PigsCanFlyLabs/satellite-hardware/v0.1/PCB_Project/Schematics.pdf

# Swarm M138 Modem ¹

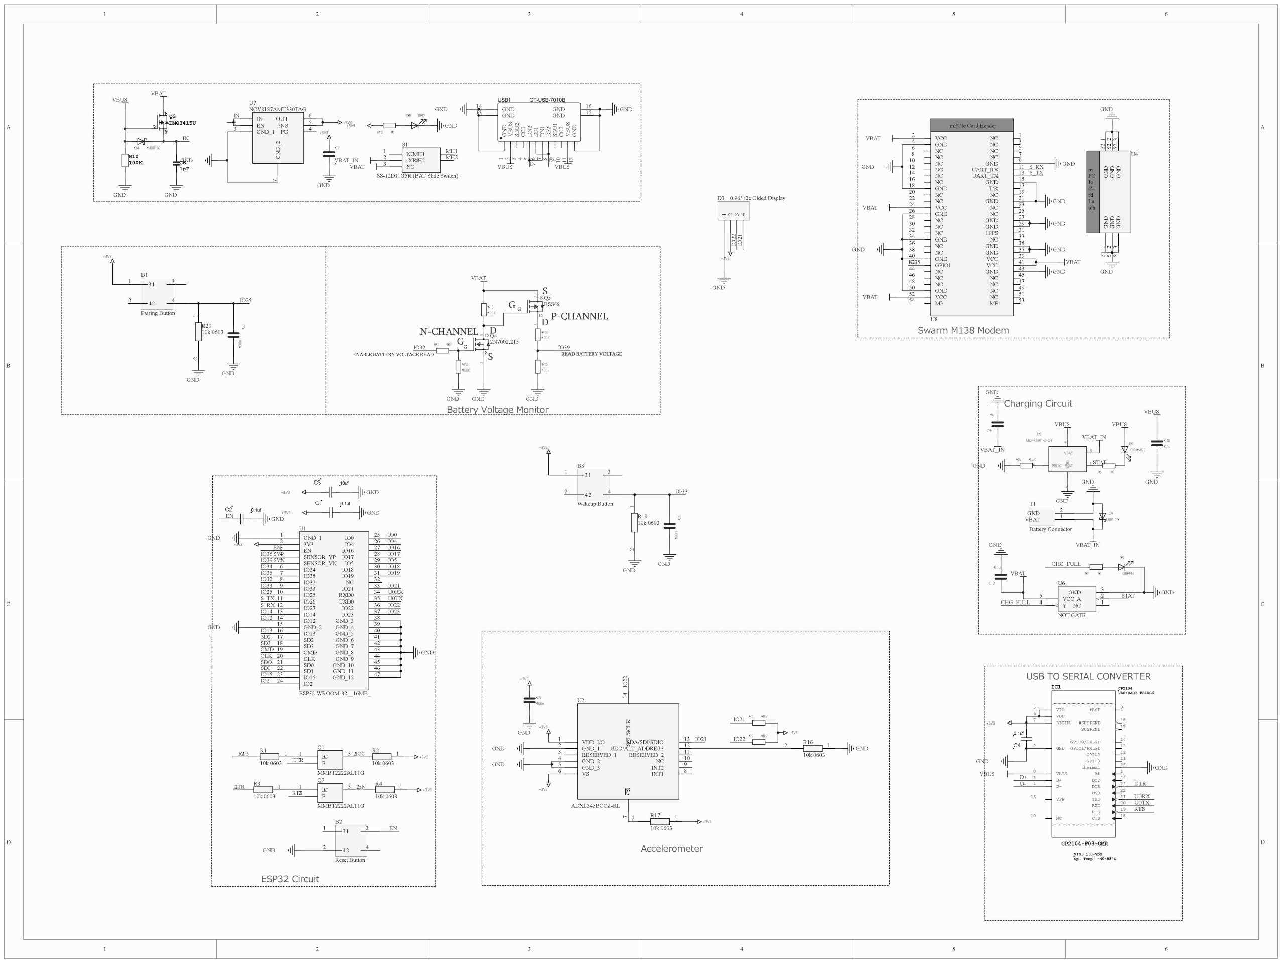
[picture p1: page 1]

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
GND_1 1
3V3 2
EN 3
SENSOR_VP 4
SENSOR_VN 5
IO34 6
IO35 7
IO32 8
IO33 9
IO25 10
IO26 11
IO27 12
IO14 13
IO12 14
GND_2 15
IO13 16
SD2 17
SD3 18
CMD 19
CLK 20
SD0 21
SD1 22
IO15 23
IO2 24
IO0 | 25
IO4 | 26
IO16 | 27
IO17 | 28
IO5 | 29
IO18 | 30
IO19 | 31
NC | 32
IO21 | 33
RXD0 | 34
TXD0 | 35
IO22 | 36
IO23 | 37
GND_3 | 38
GND_4 | 39
GND_5 | 40
GND_6 | 41
GND_7 | 42
GND_8 | 43
GND_9 | 44
GND_10 | 45
GND_11 | 46
GND_12 | 47

U1

ESP32-WROOM-32__16MB_

+3V3

GND
EN
SVP
IO39 SVN
IO34
IO35

IO12

IO13

IO14

IO15

IO16
IO17

IO18
IO19

IO21

IO22
IO23

IO25

IO32
IO33

GND
SD2
SD3
CMD
CLK

SDI

SDO

U0TX

U0RX

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
MMBT2222ALT1G

B

1
E

2

C

3

Q2

MMBT2222ALT1G

2 1

R1

10k 0603

2 1

R3

10k 0603

2 1

R2
10k 0603 DTR

RTS

+3V3

IO36

C2 | 0.1uf
C1 | 0.1uf
+3V3 | GND EN | GND

2 1

R4

10k 0603

+3V3

RTS

DTR | EN IO0
C3 | 10uf
+3V3 | GND

+3V3

U0RX
U0TX
RTS

DTR

RI | 1

GND 2

D+ 3
D- 4

VIO 5
VDD 6
REGIN 7

VBUS 8

#RST | 9

NC 10

GPIO3 | 11
GPIO2 | 12
DCD | 24
DTR | 23
DSR | 22
TXD | 21
RXD | 20
RTS | 19
CTS | 18
SUSPEND | 17

VPP 16

#SUSPEND | 15

GPIO0/TXLED | 14
GPIO1/RXLED | 13

CP2104
USB/UART BRIDGE

VIO: 1.8-VDD
Op. Temp: -40~85°C
thermal | 25

IC1

CP2104-F03-GMR

0.1uf
C4

GND
GND
D+
D-

+3V3

100n

C5

# ESP32 Circuit

# Accelerometer

GND

0.1u

C10

ORANGE

D2

R6 1K VDD

4

PROG 5

VBAT | 3
STAT | 1 VSS 2

MCP73831-2-OT

U3

R5 1.5K

MBR120

D1
VBAT | 1
GND | 2

T1

Battery Connector

VBAT_IN

GND

VBUS

VBUS

GND

VBUS

GND

GND

# Charging Circuit

2

3

4

D3 0.96" i2c Olded Display

GND

+3V3 IO²² IO²¹

C6
1µF

D

S

G

Q3
DMG3415U

R10
100K

VBUS

VBAT

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
Pairing Button

# USB TO SERIAL CONVERTER

NC | 1
A | 2
GND | 3

Y

4

VCC 5

U6

NOT GATE

STAT | GND
CHG_FULL
VBAT | GREEN

D5

R7 1K

CHG_FULL ¹⁰⁰n C⁸

GND

IN

IN 1
EN 2
GND_1 3 | GND_2

### 7 OUT 6

SNS | 5
PG | 4

U7
NCV8187AMT330TAG
GND | GND

GND

IN
+3V3

NC 1
COM 2
NO 3
MH1 | MH1
MH2 | MH2

S1

SS-12D11G5R (BAT Slide Switch)

VBAT_IN
VBAT

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
Reset Button

GND

EN

+3V3

1u

C7

GND

VBUS

D4 | MBR120 | GND S¹_1 GND S²_1 GND S¹_2 GND S¹_3 GND S²_2 GND S²_3

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
mPCIe Card Header

MP 54 | MP | 53
NC | 1
NC | 3
NC | 5

VCC 2
GND 4
NC 6
NC 8
NC 10
NC 12
NC 14
NC 16
NC | 7
GND | 9
UART_RX | 11
UART_TX | 13
T/R | 17
NC | 19
GND | 21
NC | 23
NC | 25
GND | 27
GND | 29
1PPS | 31
NC | 33
GND | 35
GND | 37
VCC | 39
VCC | 41
GND | 43
NC | 45
NC | 47
NC | 49
NC | 51

GND 18
NC 20
NC 22
VCC 24
GND 26
NC 28
NC 30
NC 32
GND 34
NC 36
NC 38
GND 40
GND | 15

GPIO1 42
NC 44
NC 46
NC 48
GND 50
VCC 52

U8

GND

VBAT

VBAT

GND

VBAT

GND

VBAT

GND

GND

GND

GND

GND

GND

S_RX
S_TX

S_TX
S_RX

GND

0.1u

C12

VBAT_IN

STAT

GND

1u

C9

VBAT_IN GND

# 1 VBUS 2 SBU2

# 3 CC1

# 4 DN2

# 5 DP1

# 6 DN1

# 7 DP2

# 8 SBU1

### 9 CC2 10 VBUS 11 GND 12

GND 13 | GND 14
GND | 15 GND | 16
USB1 | GT-USB-7010B
GND | GND
VBUS | VBUS

D+ D-

100K

R14

R11 4K7

100K

R13

100K

R12
100k

R15

IO32 | IO39
S

G

D

S
G
D

# N-CHANNEL

# P-CHANNEL

ENABLE BATTERY VOLTAGE READ | READ BATTERY VOLTAGE ³

1 2

G
S

D Q4

2N7002,215 2

1 3

G

S

D

Q5
BSS48
GND | GND | GND

VBAT

# Battery Voltage Monitor

VDD_I/O 1
GND_1 2
RESERVED_1 3
GND_2 4
GND_3 5
VS 6 | CS

7

INT1 | 8
INT2 | 9
NC | 10 RESERVED_2 | 11 SDO/ALT_ADDRESS | 12 SDA/SDI/SDIO | 13 SCL/SCLK ¹⁴
U2

ADXL345BCCZ-RL

R8 | 4k7
R9 | 4k7

+3V3
IO21

IO21 IO²²

IO22
2 1

R16

10k 0603

GND

+3V3

+3V3

GND

GND

2 1

R17

10k 0603

+3V3

D6 | RED
R18 | 1K
+3V3 | GND 1 2

R20
10k 0603

GND

IO25

+3V3

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
Wakeup Button | 100n C¹¹
GND ¹ ²
R19
10k 0603

GND

IO33

+3V3

IO35
