PigsCanFlyLabs/satellite-hardware/v0.1/PCB_Project/bom support.txt

MM60-52B1-B1-R850
MM60-EZH039-B5-R850
CP2104-F03-GMR
