PigsCanFlyLabs/satellite-hardware/v0.3/tinyshuffle-sw/TinyShuffle TOP v.0.SLDASM

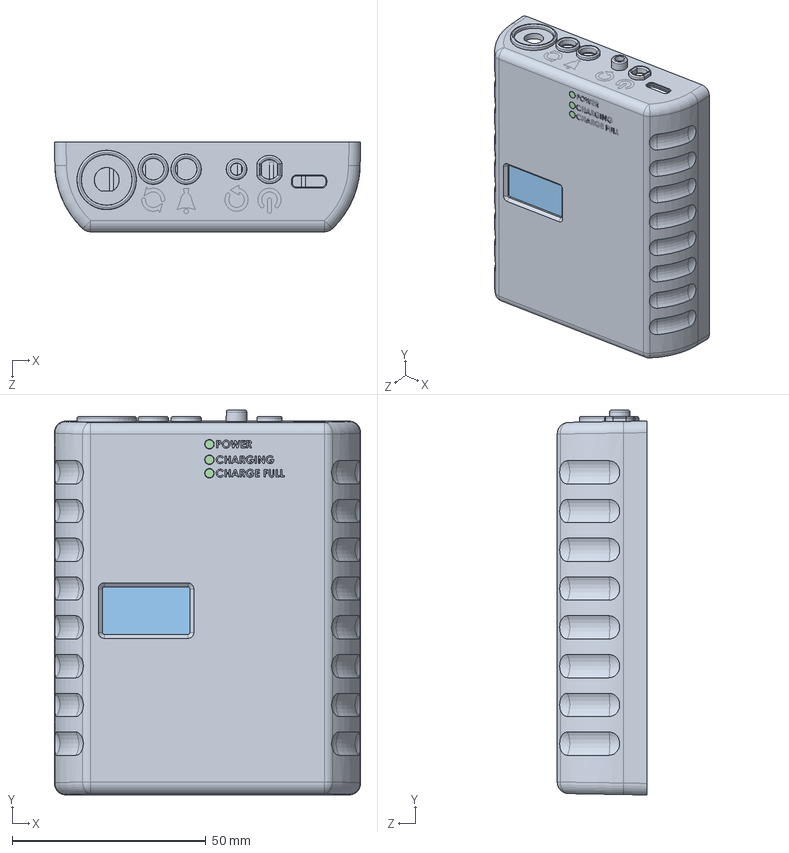
[picture p2: CAD file, 2022-03-25, an earlier design]
v0.3/tinyshuffle-sw/TinyShuffle TOP v.0.SLDASM
79.0 x 99.3 x 23.1 mm
TinyShuffle TOP v.0
94459A110_Heat-Set Inserts for Plastic m2X2.5 x 11
TinyShuffle Display filter v.0
BIVAR PLPC2-8MM x 3
