PigsCanFlyLabs/satellite-hardware/v0.3/COMPONENTS/Swarm-1_4-wave-antenna-model.STEP

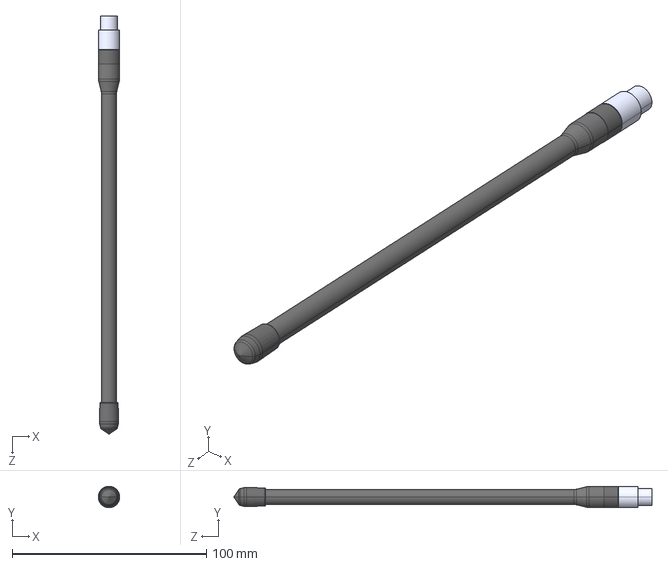
[picture p3: CAD file, 2022-03-25, an earlier design]
v0.3/COMPONENTS/Swarm-1_4-wave-antenna-model.STEP
11.0 x 11.0 x 215.1 mm
