PigsCanFlyLabs/satellite-hardware/v0.3/PCBA/SWARM M138.SLDPRT

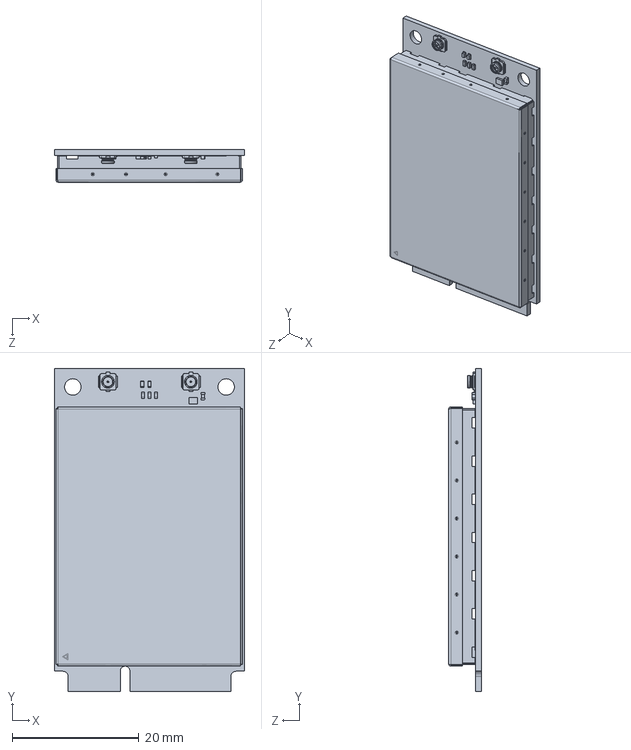
[picture p4: CAD file, 2022-03-21, an earlier design]
v0.3/PCBA/SWARM M138.SLDPRT
30.0 x 51.0 x 5.13 mm
