PigsCanFlyLabs/satellite-hardware/v0.3/SW/COMPONENTS/BODIES/QFN_F03-GMR_SIL.step

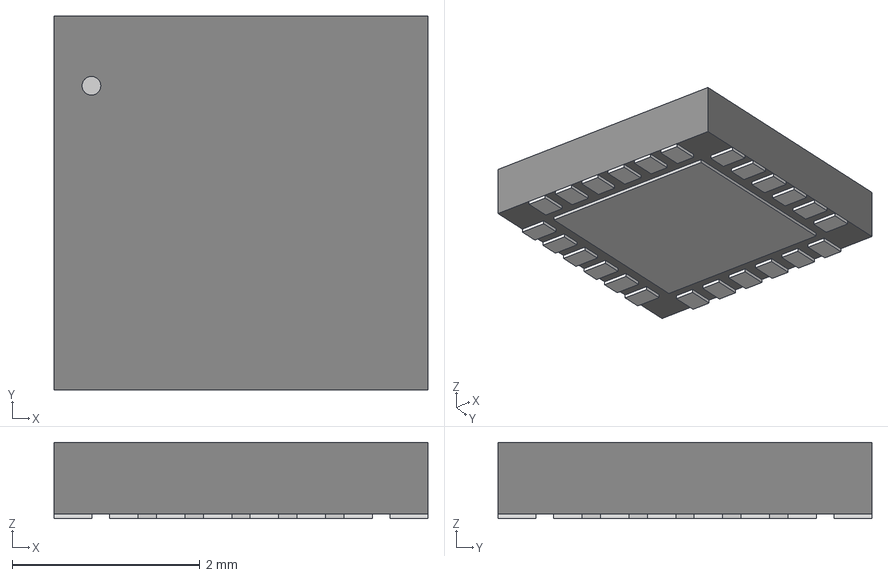
[picture p5: CAD file, 2022-03-21, an earlier design]
v0.3/SW/COMPONENTS/BODIES/QFN_F03-GMR_SIL.step
3.99 x 3.99 x 0.815 mm
