PigsCanFlyLabs/satellite-hardware/v0.3/SW/TinyShuffle SMA SEAL v.0.SLDPRT

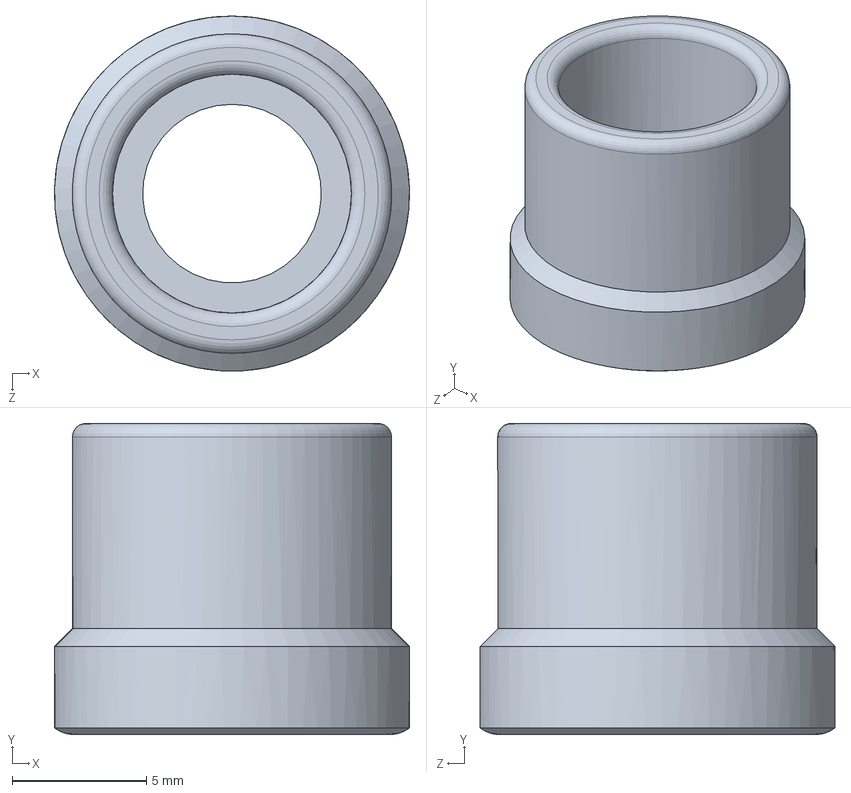
[picture p6: CAD file, 2022-03-21, an earlier design]
v0.3/SW/TinyShuffle SMA SEAL v.0.SLDPRT
13.2 x 11.6 x 13.2 mm
