PigsCanFlyLabs/satellite-hardware/v0.4/tinyshuffle-sw/TinyShuffle SHIM v.0.SLDPRT

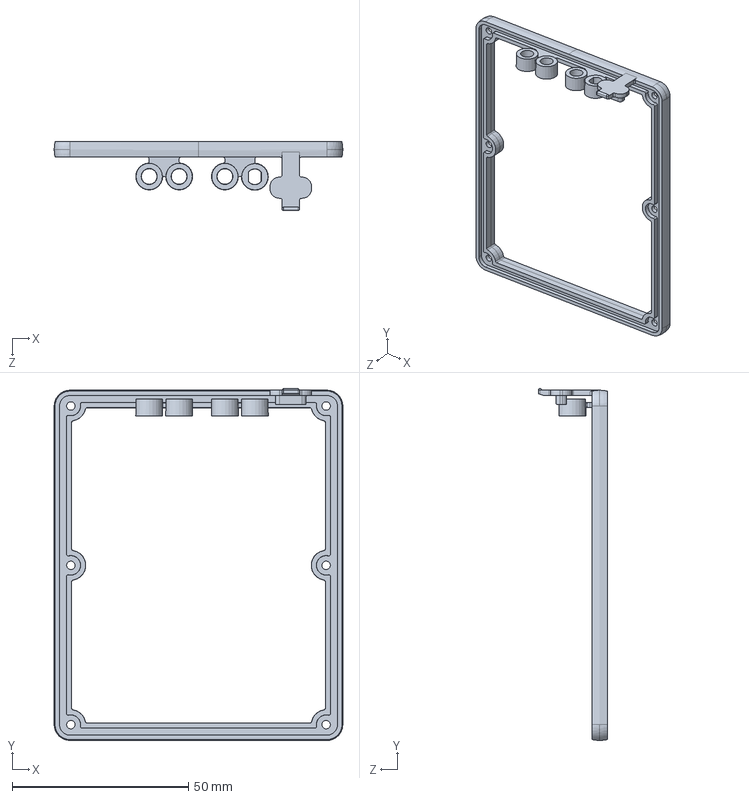
[picture p7: CAD file, 2022-03-25, an earlier design]
v0.4/tinyshuffle-sw/TinyShuffle SHIM v.0.SLDPRT
82.0 x 100.0 x 19.7 mm
