PigsCanFlyLabs/satellite-hardware/v0.3/COMPONENTS/800AC1BLKCAP.SLDPRT

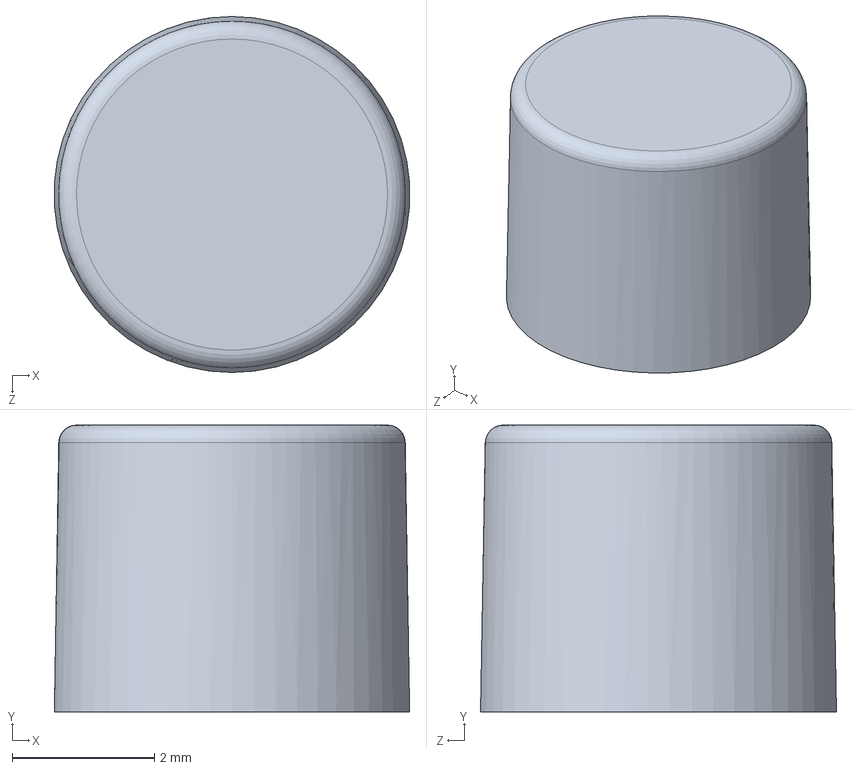
[picture p8: CAD file, 2022-03-21, an earlier design]
v0.3/COMPONENTS/800AC1BLKCAP.SLDPRT
4.99 x 4.03 x 5.00 mm
