PigsCanFlyLabs/satellite-hardware/v0.3/SW/COMPONENTS/BODIES/NCV8187AMT330TAG.stp

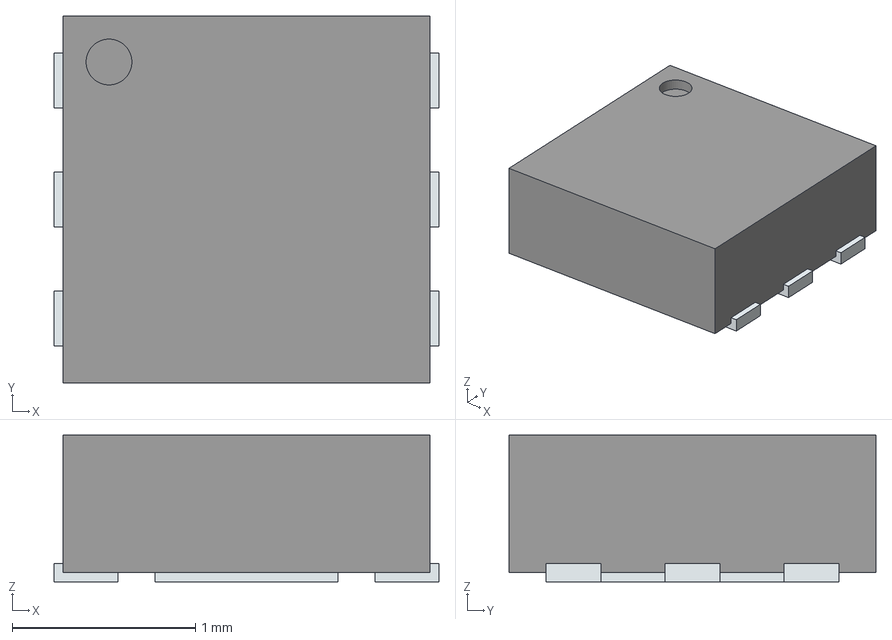
[picture p9: CAD file, 2022-03-21, an earlier design]
v0.3/SW/COMPONENTS/BODIES/NCV8187AMT330TAG.stp
2.10 x 2.00 x 0.8 mm
ThermalPin
PinsArrayLR
