PigsCanFlyLabs/satellite-hardware/v0.3/SW/COMPONENTS/PLPC2-8MM.STEP

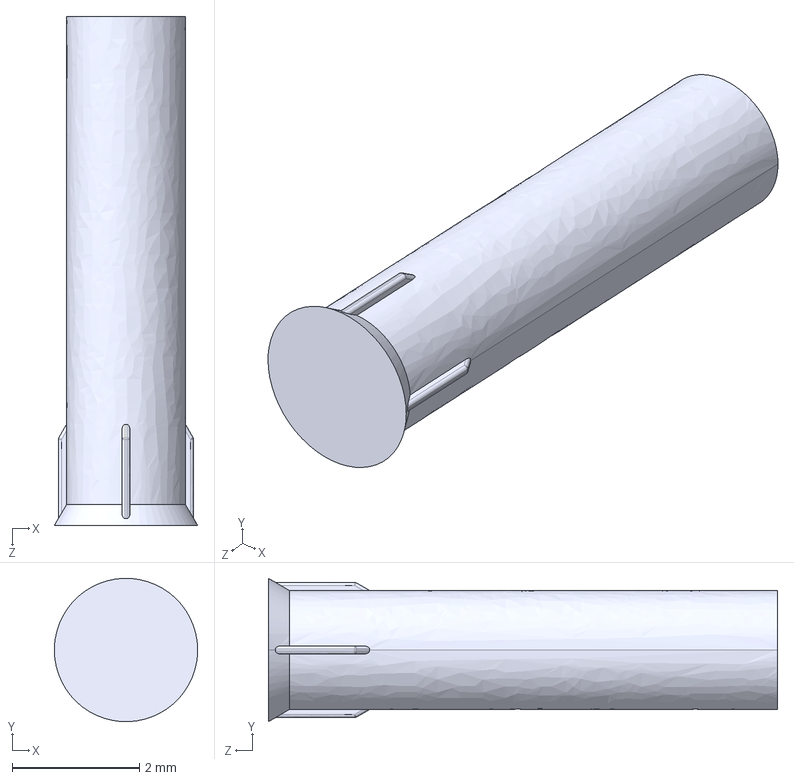
[picture p10: CAD file, 2022-03-21, an earlier design]
v0.3/SW/COMPONENTS/PLPC2-8MM.STEP
2.25 x 2.25 x 8.00 mm
