PigsCanFlyLabs/satellite-hardware/v0.3/SW/TinyShuffle Display filter v.0.SLDPRT

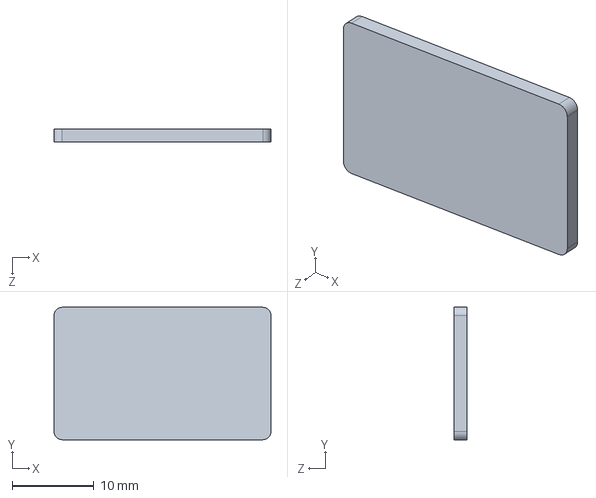
[picture p11: CAD file, 2022-03-21, an earlier design]
v0.3/SW/TinyShuffle Display filter v.0.SLDPRT
26.6 x 16.2 x 1.59 mm
