PigsCanFlyLabs/satellite-hardware/v0.4/tinyshuffle-sw/TinyShuffle BOT v.0.SLDPRT

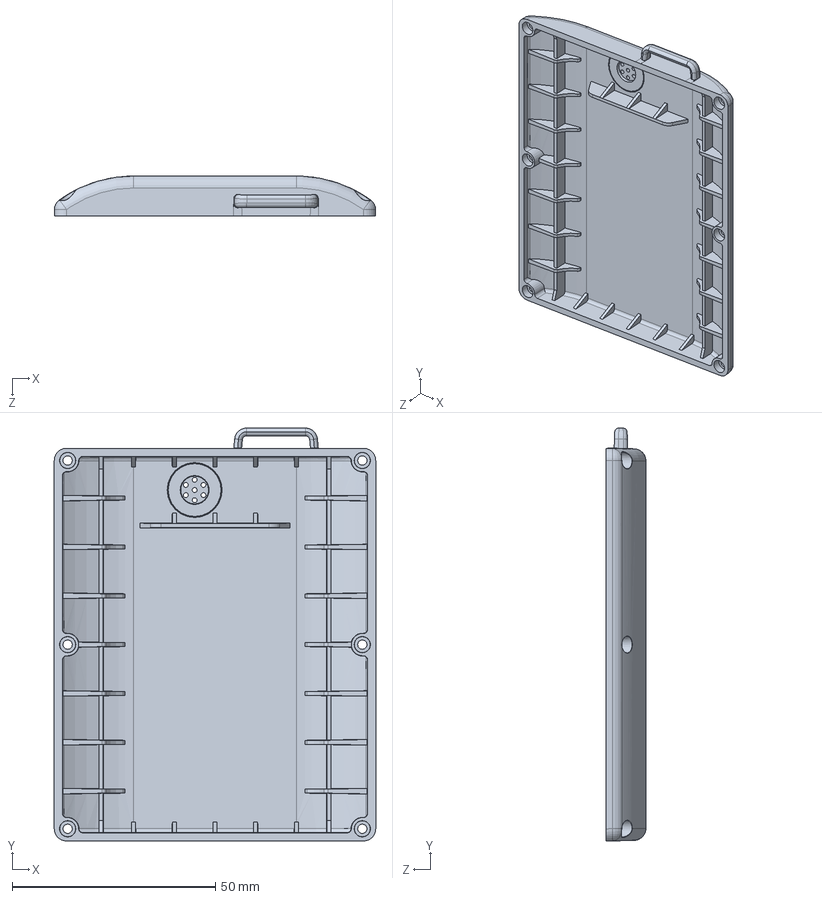
[picture p12: CAD file, 2022-03-25, an earlier design]
v0.4/tinyshuffle-sw/TinyShuffle BOT v.0.SLDPRT
79.0 x 101.5 x 9.84 mm
