PigsCanFlyLabs/satellite-hardware/v0.3/SW/COMPONENTS/BODIES/NRVB120VLSFT1G.stp

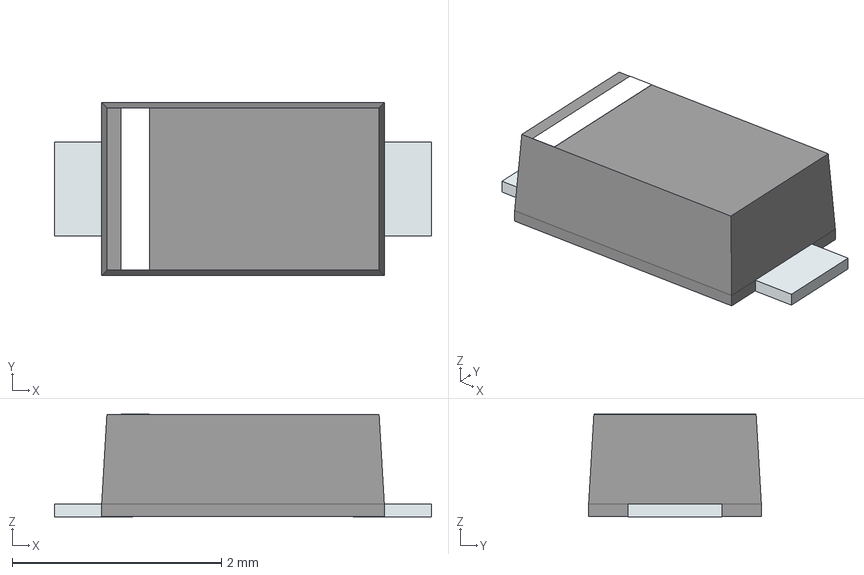
[picture p13: CAD file, 2022-03-21, an earlier design]
v0.3/SW/COMPONENTS/BODIES/NRVB120VLSFT1G.stp
3.60 x 1.65 x 0.98 mm
PinKIdent
PinK
PinA
