PigsCanFlyLabs/satellite-hardware/(list of files, cad)

Other CAD files:
v0.3/SW/TinyShuffle TOP v.0.SLDASM
v0.3/tinyshuffle-sw/3M 4026 FOAM .0625IN THICK.SLDPRT
v0.3/COMPONENTS/353 Adafruit battery.SLDPRT
v0.3/COMPONENTS/4035N11.SLDPRT
v0.3/COMPONENTS/92095A452_Button Head Hex Drive Screw M2x5.SLDPRT
v0.3/COMPONENTS/92095A454_Button Head Hex Drive Screw M2X8.SLDPRT
v0.3/COMPONENTS/93475A195_18-8 Stainless Steel Washer M2X5.SLDPRT
v0.3/COMPONENTS/94459A110_Heat-Set Inserts for Plastic m2X2.5.SLDPRT
v0.3/COMPONENTS/BIVAR PLPC2-8MM.SLDPRT
v0.3/COMPONENTS/NT-SMA-N.SLDPRT
v0.3/COMPONENTS/SMA_CONNECTOR.SLDPRT
v0.3/COMPONENTS/SMA_WASHER.SLDPRT
v0.3/COMPONENTS/Swarm-1_4-wave-antenna-model.SLDPRT
v0.3/COMPONENTS/TYPE-C JACK.SLDPRT
v0.3/COMPONENTS/W3908B0100.SLDPRT
v0.3/SW/3M 4026 FOAM .0625IN THICK.SLDPRT
v0.3/SW/COMPONENTS/2016694-2.SLDPRT
v0.3/SW/COMPONENTS/2065600050.sldasm
v0.3/SW/COMPONENTS/2065600050_3.sldprt
v0.3/SW/COMPONENTS/2065600050_5.sldprt
v0.3/SW/COMPONENTS/336319-12-0050.SLDPRT
v0.3/SW/COMPONENTS/336319-12-SMA.SLDPRT
v0.3/SW/COMPONENTS/733910260.SLDPRT
v0.3/SW/COMPONENTS/8589K11_Clear Scratch- and UV-Resistant Acrylic Sheet.SLDPRT
v0.3/SW/COMPONENTS/BODIES/200AWMSPxT1A1M7xE.STEP
v0.3/SW/COMPONENTS/BODIES/353 6600mAh Battery.STEP
v0.3/SW/COMPONENTS/BODIES/800AWSP9M7xE.STEP
v0.3/SW/COMPONENTS/BODIES/ABS07-32.768KHZ-T--3DModel-STEP-400430.STEP
v0.3/SW/COMPONENTS/BODIES/ADXL345BCCZ-RL.stp
v0.3/SW/COMPONENTS/BODIES/CHEMI-H70.step
v0.3/SW/COMPONENTS/BODIES/CPF0603B330RE1.stp
v0.3/SW/COMPONENTS/BODIES/Ceramic_Capacitor_0603_h32mil.step
v0.3/SW/COMPONENTS/BODIES/I2COLEDDisplayAdafruit.SLDPRT
v0.3/SW/COMPONENTS/BODIES/I2COLEDDisplayAdafruit.step
v0.3/SW/COMPONENTS/BODIES/K3D-MM60-52B1-B1-R2 JAE Connector Division Proprietary.STEP
v0.3/SW/COMPONENTS/BODIES/K3D-MM60-EZH039-B5-R2 JAE Connector Division Proprietary.STEP
v0.3/SW/COMPONENTS/BODIES/MCP73831T-2ACI_OT.stp
v0.3/SW/COMPONENTS/BODIES/MMBT2222ALT1G.stp
v0.3/SW/COMPONENTS/BODIES/Part1.STEP
v0.3/SW/COMPONENTS/BODIES/User Library-KP-2012.STEP
v0.3/SW/COMPONENTS/BODIES/User Library-Switch-CK-KMR2.STEP
v0.3/SW/COMPONENTS/BODIES/step_temp.STEP
v0.3/SW/COMPONENTS/PLPC2-8MM.IGS
v0.3/SW/COMPONENTS/PLPC2-8MM.SLDPRT
v0.3/SW/COMPONENTS/Swarm-1_4-wave-antenna-model.SLDPRT
v0.3/SW/COMPONENTS/Swarm-1_4-wave-antenna-model.STEP
v0.3/SW/TinyShuffle BOT v.0.SLDPRT
v0.3/SW/TinyShuffle SHIM v.0.SLDPRT
v0.3/SW/TinyShuffle TOP v.0.SLDPRT
v0.3/tinyshuffle-sw/TinyShuffle Display filter v.0.SLDPRT
v0.3/tinyshuffle-sw/TinyShuffle SMA SEAL v.0.SLDPRT
v0.3/tinyshuffle-sw/TinyShuffle TOP v.0.SLDPRT
v0.4/COMPONENTS/353 Adafruit battery.SLDPRT
v0.4/COMPONENTS/4035N11.SLDPRT
v0.4/COMPONENTS/92095A452_Button Head Hex Drive Screw M2x5.SLDPRT
v0.4/COMPONENTS/92095A454_Button Head Hex Drive Screw M2X8.SLDPRT
v0.4/COMPONENTS/93475A195_18-8 Stainless Steel Washer M2X5.SLDPRT
v0.4/COMPONENTS/94459A110_Heat-Set Inserts for Plastic m2X2.5.SLDPRT
v0.4/COMPONENTS/BIVAR PLPC2-8MM.SLDPRT
v0.4/COMPONENTS/NT-SMA-N.SLDPRT
v0.4/COMPONENTS/SMA_CONNECTOR.SLDPRT
v0.4/COMPONENTS/SMA_WASHER.SLDPRT
v0.4/COMPONENTS/Swarm-1_4-wave-antenna-model.SLDPRT
v0.4/COMPONENTS/TYPE-C JACK.SLDPRT
v0.4/COMPONENTS/W3908B0100.SLDPRT
v0.4/tinyshuffle-sw/3M 4026 FOAM .0625IN THICK.SLDPRT
v0.4/tinyshuffle-sw/TinyShuffle Display filter v.0.SLDPRT
v0.4/tinyshuffle-sw/TinyShuffle SMA SEAL v.0.SLDPRT
v0.4/tinyshuffle-sw/TinyShuffle TOP v.0.SLDPRT
