PigsCanFlyLabs/satellite-hardware/(list of files, drawings)

Other design files:
v0.1/P1/PCB_Project.PrjPcb
v0.1/P1/Schlib1.SchLib
v0.1/PCB_Project/PCB_Project.PrjPcb
v0.1/PCB_Project/Sheet1.SchDoc
v0.2/project/TinyShuffle v.0.PrjPcb
v0.2/project/TinyShuffle v.0.SchDoc
v0.3/AD/PcbLib1.PcbLib
v0.3/AD/Schlib1.SchLib
v0.3/AD/Sheet1.SchDoc
v0.3/AD/TinyShuffle v.0a.PrjPcb
v0.3/AD/TinyShuffle v.0a.SchDoc
v0.5/TinyShuffle v.0.SCHLIB
v0.5/TinyShuffle v.0b.PrjPcb
v0.5/TinyShuffle v.0b.SchDoc
v0.6/TinyShuffle v.0b.PrjPcb
v0.6/TinyShuffle v.0b.SchDoc
v0.6/TinyShuffle v.0b.SCHLIB
v0.6/Title.SchDoc
v0.7/TinyShuffle v.0.SCHLIB
v0.7/TinyShuffle v.0b.PrjPcb
v0.7/TinyShuffle v.0b.SchDoc
v0.7/TinyShuffle v.0b.SCHLIB
v0.7/Title.SchDoc
