PigsCanFlyLabs/satellite-hardware/v0.1/testplan.txt

1) Plug in to USB-C input
2) Verify ESP32 serial interface shows up
3) Flash the result of running ./build.sh from https://github.com/PigsCanFlyLabs/device-fw/
4) Verify  BT shows up
