PigsCanFlyLabs/satellite-hardware/(commit log)

2022-01-01 Add initial design
    [BOM.xlsx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]
2022-01-14 Clean up dir struct
    [Pick Place for PCB1.csv]
2022-01-14 Switch BOM to csv
    [BOM.csv, BOM.xlsx]
2022-01-14 Update BOM (and putt back an xls version with highlighting as well)
    [BOM.csv, revised_BOM.xlsx]
2022-01-14 Clean up duplicate gerbers dir
    [BOM.xlsx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]
2022-01-15 Update BOM
    [BOM.csv, revised_BOM.xlsx]
2022-01-15 Add the updated PCB design by Furkan
    [PCB1.GBL, PCB1.GBO, PCB1.GBP, PCB1.GBS, PCB1.GKO, PCB1.GM1, PCB1.GTL, PCB1.GTO]
2022-02-15 Add v0.2 design
    [BOM.csv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]
2022-02-15 Update v0.2 BOM to weather resistent instead of waterproof.
2022-03-21 Add V3
    [200AWMSPxT1A1M7xE.STEP, 2016694-2.SLDPRT, 2065600050.sldasm, 2065600050_3.sldprt, 2065600050_5.sldprt, 336319-12-0050.SLDPRT, 336319-12-SMA.SLDPRT, 353 6600mAh Battery.STEP]
2022-03-25 Add solidworks export
    [353 Adafruit battery.SLDPRT, 3M 4026 FOAM .0625IN THICK.SLDPRT, 4035N11.SLDPRT, 800AC1BLKCAP.SLDPRT, 92095A452_Button Head Hex Drive Screw M2x5.SLDPRT, 92095A454_Button Head Hex Drive Screw M2X8.SLDPRT, 93475A195_18-8 Stainless Steel Washer M2X5.SLDPRT, 94459A110_Heat-Set Inserts for Plastic m2X2.5.SLDPRT]
2022-04-29 Add v05
    [TinyShuffle v.0.SCHLIB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]
2022-07-31 Add 07/03 design as 0.6
    [TinyShuffle v.0.SCHLIB, TinyShuffle v.0b.PrjPcb, TinyShuffle v.0b.SCHLIB, TinyShuffle v.0b.SchDoc, Title.SchDoc]
